silverskata/generative-engine/hardware/GenerativeEngineFaceplate.png

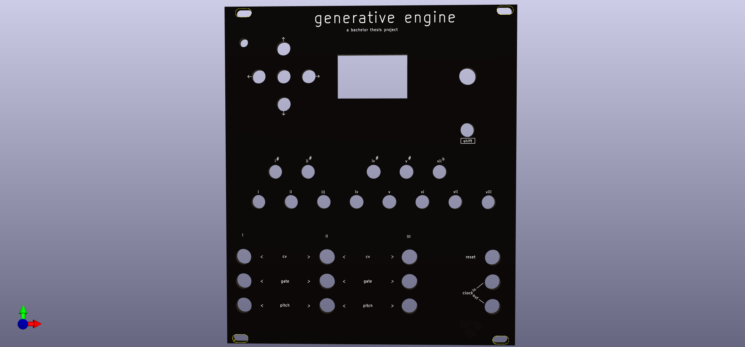
hardware/GenerativeEngineFaceplate.png
