silverskata/generative-engine/hardware/GenerativeEngine.kicad_pcb

## KiCad design hardware/GenerativeEngine.kicad_pcb (2022-05-01)

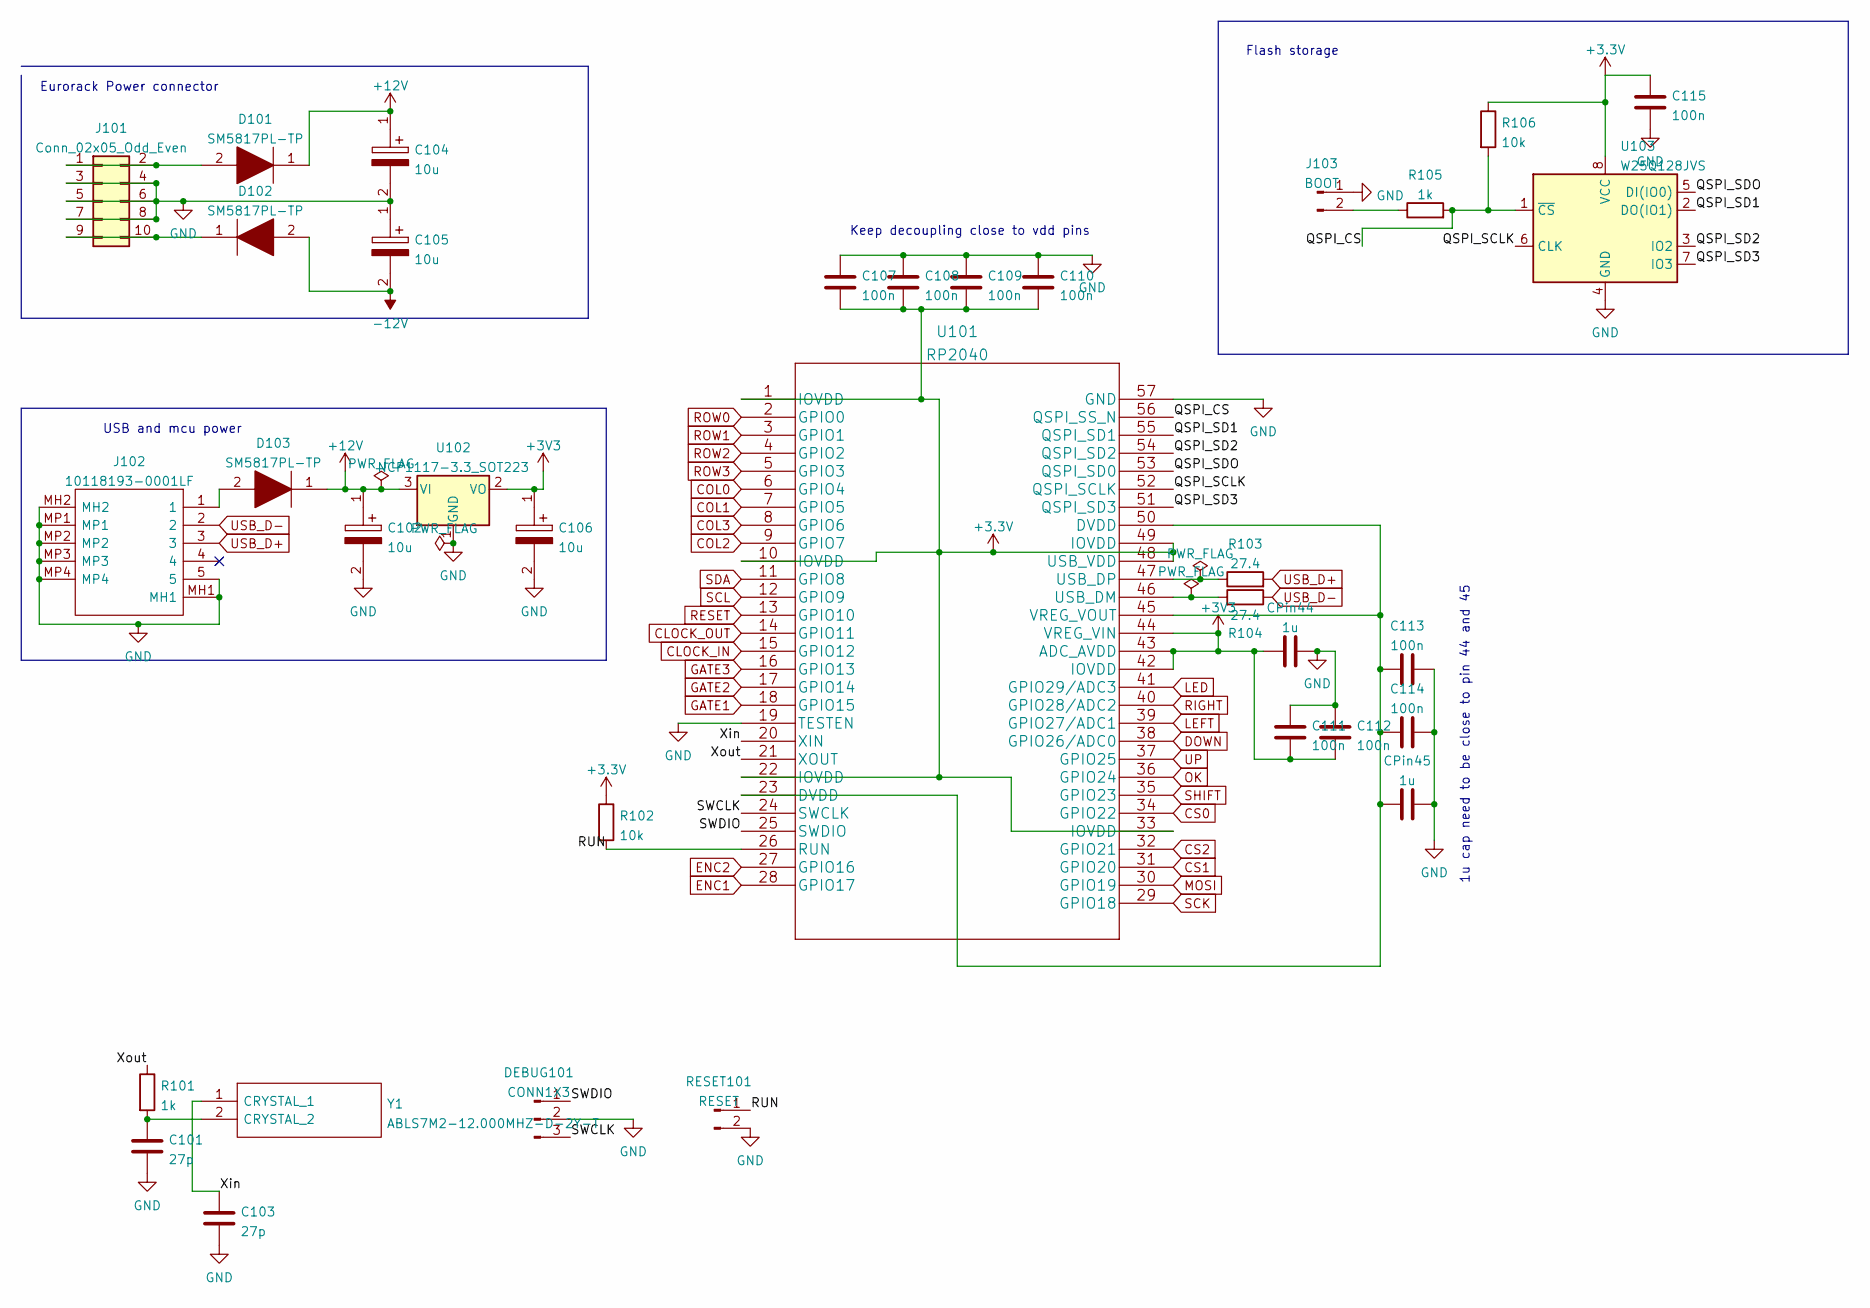
[picture p2: schematic GenMCU.kicad_sch]

Parts:
C101, C103: 27p; C_0603_1608Metric_Pad1.08x0.95mm_HandSolder
C102, C104, C105, C106: 10u; CAPAE530X550N; Mouser Part Number 710-865230340001
C107, C108, C109, C110, C111, C112, C113, C114, C115: 100n; C_0603_1608Metric_Pad1.08x0.95mm_HandSolder
CPin44, CPin45: 1u; C_0603_1608Metric_Pad1.08x0.95mm_HandSolder
D101, D102, D103: SM5817PL-TP; SOD3716X120N; Mouser Part Number 833-SM5817PL-TP
DEBUG101: CONN1X3; PinSocket_1x03_P2.54mm_Vertical
J101: Conn_02x05_Odd_Even; PinHeader_2x05_P2.54mm_Vertical
J102: 10118193-0001LF; 101181930001LF; Mouser Part Number 649-10118193-0001LF
J103: BOOT; PinHeader_1x02_P2.54mm_Vertical
R101, R105: 1k; R_0603_1608Metric_Pad0.98x0.95mm_HandSolder
R102, R106: 10k; R_0603_1608Metric_Pad0.98x0.95mm_HandSolder
R103, R104: 27.4; R_0603_1608Metric_Pad0.98x0.95mm_HandSolder
RESET101: RESET; PinHeader_1x02_P2.54mm_Vertical
U101: RP2040
U102: NCP1117-3.3_SOT223; SOT-223-3_TabPin2
U103: W25Q128JVS; SOIC-8_5.23x5.23mm_P1.27mm
Y1: ABLS7M2-12.000MHZ-D-2Y-T; ABLS7M212000MHZD2YT; Mouser Part Number 815-ABLS7M2-12-D-2YT

Connections:
+12V: C102.1, C104.1, D101.1, D103.1, U102.3 (VI); also elsewhere on the board
-12V: C105.2, D102.2; also elsewhere on the board
/GenMCU/QSPI_CS: R105.2, R106.2, U101.56 (QSPI_SS_N), U103.1 (~CS)
/GenMCU/QSPI_SCLK: U101.52 (QSPI_SCLK), U103.6 (CLK)
/GenMCU/QSPI_SD1: U101.55 (QSPI_SD1), U103.2 (DO(IO1))
/GenMCU/QSPI_SD2: U101.54 (QSPI_SD2), U103.3 (IO2)
/GenMCU/QSPI_SD3: U101.51 (QSPI_SD3), U103.7 (IO3)
/GenMCU/QSPI_SDO: U101.53 (QSPI_SD0), U103.5 (DI(IO0))
/GenMCU/RUN: R102.2, RESET101.1, U101.26 (RUN); also elsewhere on the board
/GenMCU/SWCLK: DEBUG101.3, U101.24 (SWCLK); also elsewhere on the board
/GenMCU/SWDIO: DEBUG101.1, U101.25 (SWDIO); also elsewhere on the board
/GenMCU/Xin: C103.1, U101.20 (XIN), Y1.1 (CRYSTAL)
/GenMCU/Xout: R101.1, U101.21 (XOUT)
CLOCK_IN: U101.15 (GPIO12); also elsewhere on the board
CLOCK_OUT: U101.14 (GPIO11); also elsewhere on the board
COL0: U101.6 (GPIO4); also elsewhere on the board
COL1: U101.7 (GPIO5); also elsewhere on the board
COL2: U101.9 (GPIO7); also elsewhere on the board
COL3: U101.8 (GPIO6); also elsewhere on the board
CS0: U101.34 (GPIO22); also elsewhere on the board
CS1: U101.31 (GPIO20); also elsewhere on the board
CS2: U101.32 (GPIO21); also elsewhere on the board
DOWN: U101.38 (GPIO26/ADC0); also elsewhere on the board
ENC1: U101.28 (GPIO17); also elsewhere on the board
ENC2: U101.27 (GPIO16); also elsewhere on the board
GATE1: U101.18 (GPIO15); also elsewhere on the board
GATE2: U101.17 (GPIO14); also elsewhere on the board
GATE3: U101.16 (GPIO13); also elsewhere on the board
GND: C101.2, C102.2, C103.2, C104.2, C105.1, C106.2, C107.1, C108.1, C109.1, C110.1, C111.1, C112.1, C113.2, C114.2, C115.2, CPin44.2, CPin45.2, DEBUG101.2, J101.3, J101.4, J101.5, J101.6, J101.7, J101.8, J102.5, J102.MH1, J102.MH2, J102.MP1, J102.MP2, J102.MP3, J102.MP4, J103.1, RESET101.2, U101.19 (TESTEN), U101.57 (GND), U102.1 (GND), U103.4 (GND); also elsewhere on the board
LED: U101.41 (GPIO29/ADC3); also elsewhere on the board
LEFT: U101.39 (GPIO27/ADC1); also elsewhere on the board
MOSI: U101.30 (GPIO19); also elsewhere on the board
unnamed: C101.1, R101.2, Y1.2 (CRYSTAL)
unnamed: C113.1, C114.1, CPin45.1, U101.23 (DVDD), U101.45 (VREG_VOUT), U101.50 (DVDD)
unnamed: D101.2, J101.1, J101.2
unnamed: D102.1, J101.9, J101.10
unnamed: D103.2, J102.1
unnamed 67: J103.2, R105.1; also elsewhere on the board
unnamed: R103.1, U101.47 (USB_DP)
unnamed: R104.2, U101.46 (USB_DM)
OK: U101.36 (GPIO24); also elsewhere on the board
RESET: U101.13 (GPIO10); also elsewhere on the board
RIGHT: U101.40 (GPIO28/ADC2); also elsewhere on the board
ROW0: U101.2 (GPIO0); also elsewhere on the board
ROW1: U101.3 (GPIO1); also elsewhere on the board
ROW2: U101.4 (GPIO2); also elsewhere on the board
ROW3: U101.5 (GPIO3); also elsewhere on the board
SCK: U101.29 (GPIO18); also elsewhere on the board
SCL: U101.12 (GPIO9); also elsewhere on the board
SDA: U101.11 (GPIO8); also elsewhere on the board
SHIFT: U101.35 (GPIO23); also elsewhere on the board
UP: U101.37 (GPIO25); also elsewhere on the board
USB_D+: J102.3, R103.2
USB_D-: J102.2, R104.1

Notes on the sheet:
USB and mcu power
1u cap need to be close to pin 44 and 45
Flash storage
Eurorack Power connector
Keep decoupling close to vdd pins

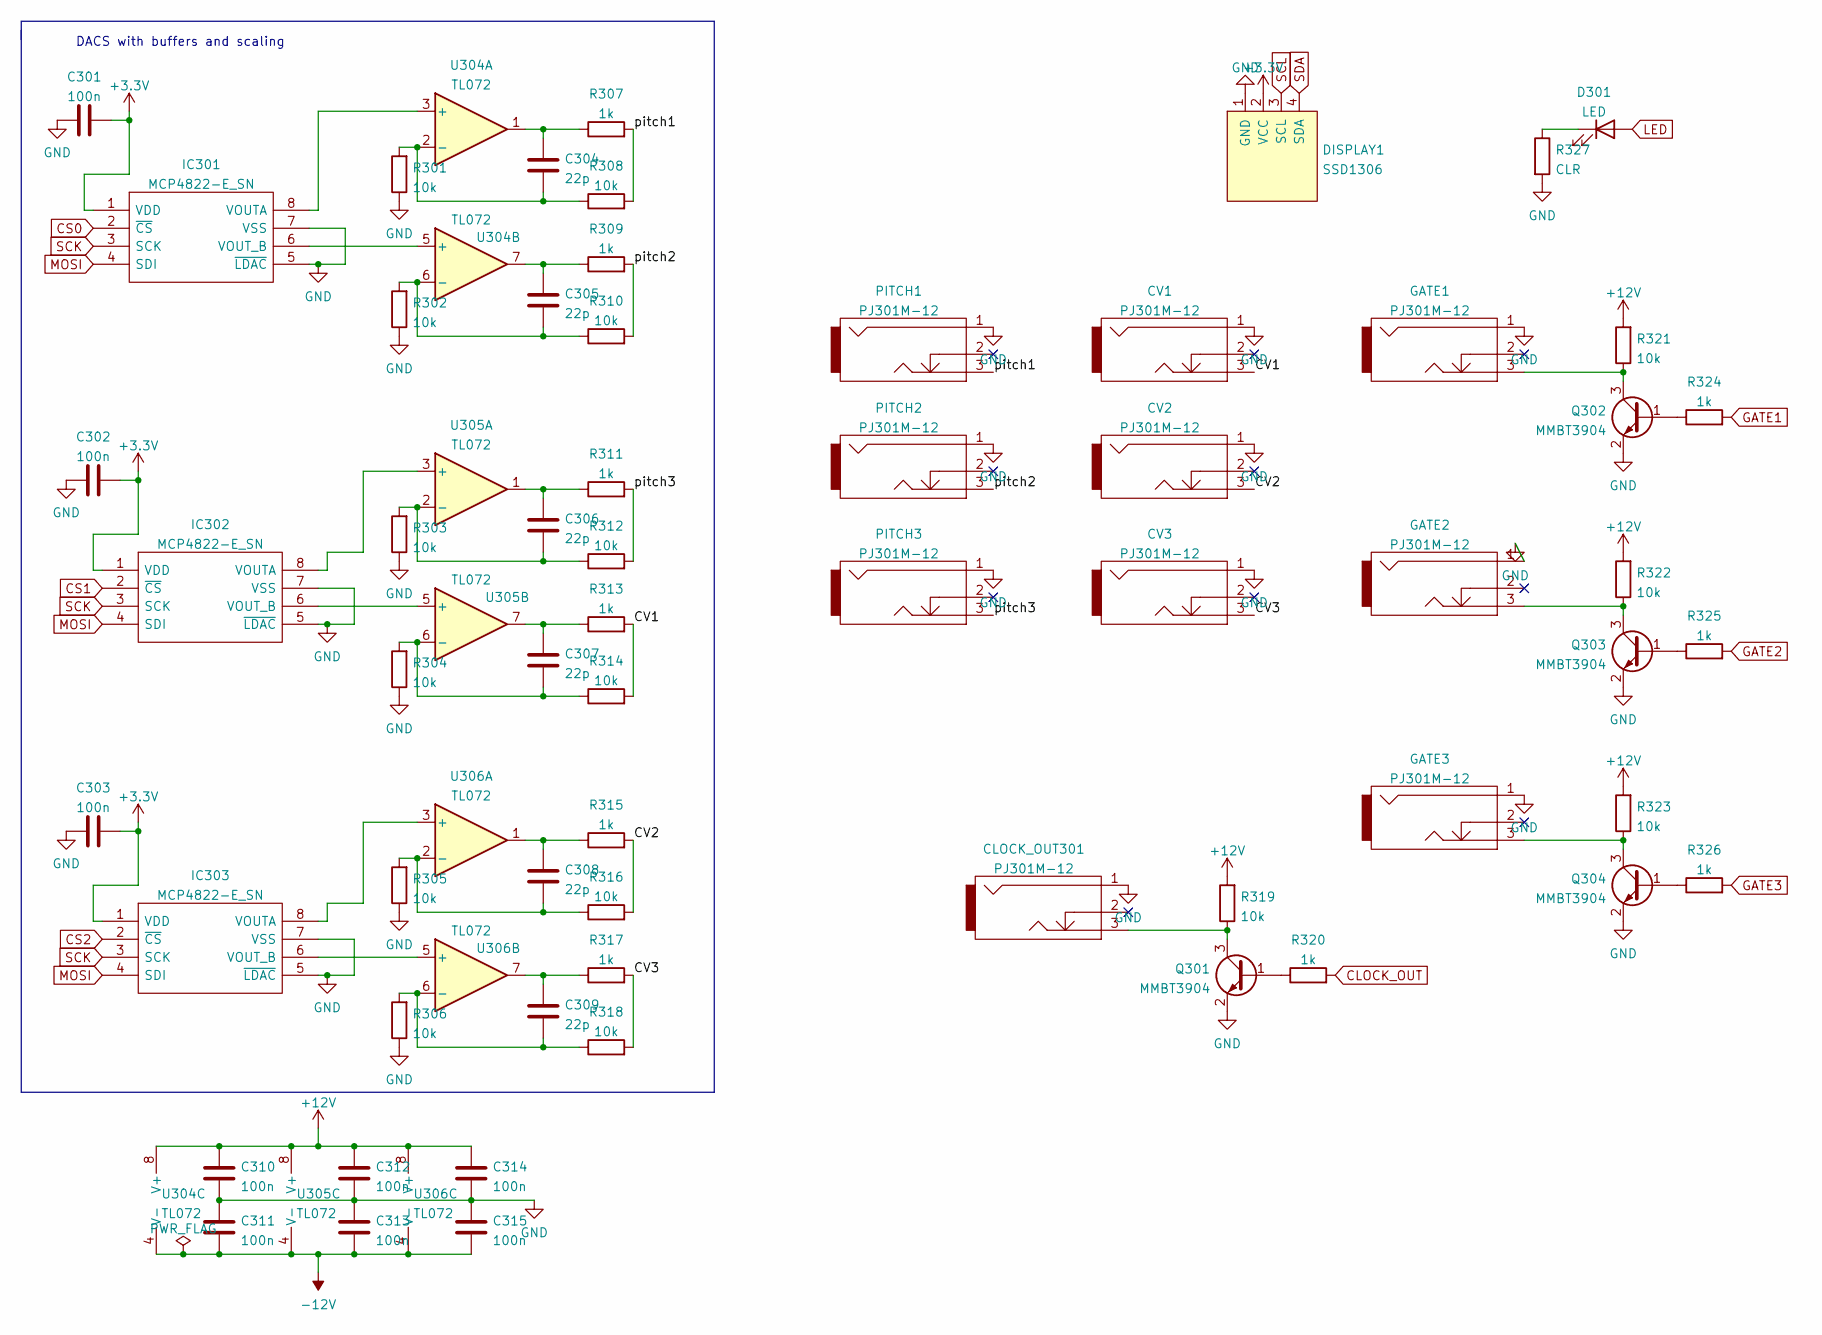
[picture p3: schematic GenOutput.kicad_sch]

Parts:
C301, C302, C303, C310, C311, C312, C313, C314, C315: 100n; C_0603_1608Metric_Pad1.08x0.95mm_HandSolder
C304, C305, C306, C307, C308, C309: 22p; C_0603_1608Metric_Pad1.08x0.95mm_HandSolder
CLOCK_OUT301: PJ301M-12
CV1, CV2, CV3: PJ301M-12
D301: LED; LED_D3.0mm
DISPLAY1: SSD1306; 128x64OLED
GATE1, GATE2, GATE3: PJ301M-12
IC301, IC302, IC303: MCP4822-E_SN; SOIC127P600X175-8N; Mouser Part Number 579-MCP4822-E/SN
PITCH1, PITCH2, PITCH3: PJ301M-12
Q301, Q302, Q303, Q304: MMBT3904; SOT-23
R301, R302, R303, R304, R305, R306, R308, R310, R312, R314, R316, R318, R319, R321, R322, R323: 10k; R_0603_1608Metric_Pad0.98x0.95mm_HandSolder
R307, R309, R311, R313, R315, R317, R320, R324, R325, R326: 1k; R_0603_1608Metric_Pad0.98x0.95mm_HandSolder
R327: CLR; R_0603_1608Metric_Pad0.98x0.95mm_HandSolder
U304, U305, U306: TL072; SOIC-8_3.9x4.9mm_P1.27mm

Connections:
+12V: C310.1, C312.1, C314.1, R319.2, R321.2, R322.2, R323.2, U304.8 (V+), U305.8 (V+), U306.8 (V+); also elsewhere on the board
-12V: C311.2, C313.2, C315.2, U304.4 (V-), U305.4 (V-), U306.4 (V-); also elsewhere on the board
/GenOutput/CV1: CV1.3, R313.2, R314.2
/GenOutput/CV2: CV2.3, R315.2, R316.2
/GenOutput/CV3: CV3.3, R317.2, R318.2
/GenOutput/pitch1: PITCH1.3, R307.2, R308.2
/GenOutput/pitch2: PITCH2.3, R309.2, R310.2
/GenOutput/pitch3: PITCH3.3, R311.2, R312.2
CLOCK_OUT: R320.2; also elsewhere on the board
CS0: IC301.2 (~CS); also elsewhere on the board
CS1: IC302.2 (~CS); also elsewhere on the board
CS2: IC303.2 (~CS); also elsewhere on the board
GATE1: R324.2; also elsewhere on the board
GATE2: R325.2; also elsewhere on the board
GATE3: R326.2; also elsewhere on the board
GND: C301.1, C302.1, C303.1, C310.2, C311.1, C312.2, C313.1, C314.2, C315.1, CLOCK_OUT301.1, CV1.1, CV2.1, CV3.1, DISPLAY1.1 (GND), GATE1.1, GATE2.1, GATE3.1, IC301.5 (~LDAC), IC301.7 (VSS), IC302.5 (~LDAC), IC302.7 (VSS), IC303.5 (~LDAC), IC303.7 (VSS), PITCH1.1, PITCH2.1, PITCH3.1, Q301.2 (E), Q302.2 (E), Q303.2 (E), Q304.2 (E), R301.1, R302.1, R303.1, R304.1, R305.1, R306.1, R327.2; also elsewhere on the board
LED: D301.2 (A); also elsewhere on the board
MOSI: IC301.4 (SDI), IC302.4 (SDI), IC303.4 (SDI); also elsewhere on the board
unnamed: C304.1, R307.1, U304.1
unnamed: C304.2, R301.2, R308.1, U304.2 (-)
unnamed: C305.1, R309.1, U304.7
unnamed: C305.2, R302.2, R310.1, U304.6 (-)
unnamed: C306.1, R311.1, U305.1
unnamed: C306.2, R303.2, R312.1, U305.2 (-)
unnamed: C307.1, R313.1, U305.7
unnamed: C307.2, R304.2, R314.1, U305.6 (-)
unnamed: C308.1, R315.1, U306.1
unnamed: C308.2, R305.2, R316.1, U306.2 (-)
unnamed: C309.1, R317.1, U306.7
unnamed: C309.2, R306.2, R318.1, U306.6 (-)
unnamed 53: CLOCK_OUT301.3, Q301.3 (C), R319.1; also elsewhere on the board
unnamed: D301.1 (K), R327.1
unnamed: GATE1.3, Q302.3 (C), R321.1
unnamed: GATE2.3, Q303.3 (C), R322.1
unnamed: GATE3.3, Q304.3 (C), R323.1
unnamed: IC301.6 (VOUT_B), U304.5 (+)
unnamed: IC301.8 (VOUTA), U304.3 (+)
unnamed: IC302.6 (VOUT_B), U305.5 (+)
unnamed: IC302.8 (VOUTA), U305.3 (+)
unnamed: IC303.6 (VOUT_B), U306.5 (+)
unnamed: IC303.8 (VOUTA), U306.3 (+)
unnamed: Q301.1 (B), R320.1
unnamed: Q302.1 (B), R324.1
unnamed: Q303.1 (B), R325.1
unnamed: Q304.1 (B), R326.1
SCK: IC301.3 (SCK), IC302.3 (SCK), IC303.3 (SCK); also elsewhere on the board

Notes on the sheet:
DACS with buffers and scaling

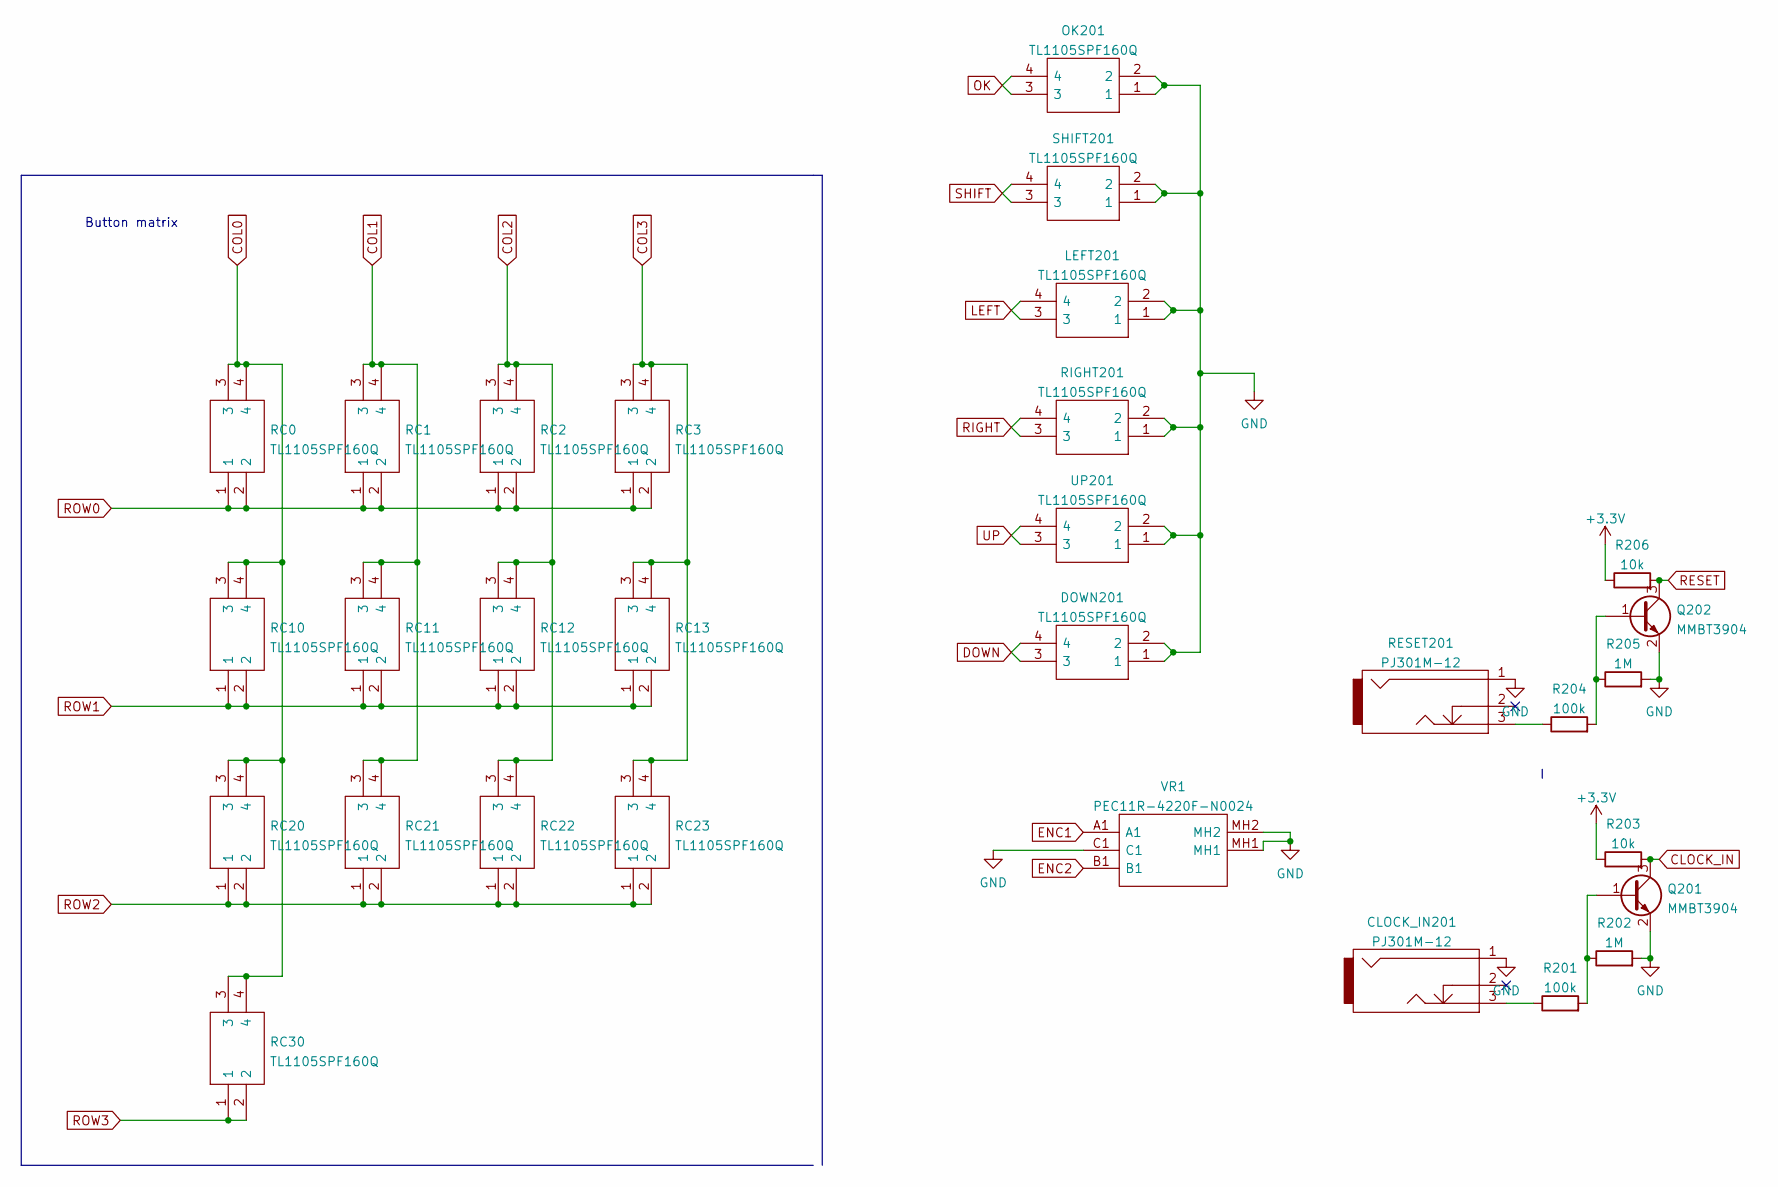
[picture p4: schematic GenInput.kicad_sch]

Parts:
CLOCK_IN201: PJ301M-12
DOWN201: TL1105SPF160Q; Mouser Part Number 612-TL1105SP
LEFT201: TL1105SPF160Q; Mouser Part Number 612-TL1105SP
OK201: TL1105SPF160Q; Mouser Part Number 612-TL1105SP
Q201, Q202: MMBT3904; SOT-23
R201, R204: 100k; R_0603_1608Metric_Pad0.98x0.95mm_HandSolder
R202, R205: 1M; R_0603_1608Metric_Pad0.98x0.95mm_HandSolder
R203, R206: 10k; R_0603_1608Metric_Pad0.98x0.95mm_HandSolder
RC0, RC1, RC2, RC3, RC10, RC11, RC12, RC13, RC20, RC21, RC22, RC23, RC30: TL1105SPF160Q; Mouser Part Number 612-TL1105SP
RESET201: PJ301M-12
RIGHT201: TL1105SPF160Q; Mouser Part Number 612-TL1105SP
SHIFT201: TL1105SPF160Q; Mouser Part Number 612-TL1105SP
UP201: TL1105SPF160Q; Mouser Part Number 612-TL1105SP
VR1: PEC11R-4220F-N0024; PEC11R4215FN0012; Mouser Part Number 652-PEC11R-4220F-N24

Connections:
CLOCK_IN: Q201.3 (C), R203.2; also elsewhere on the board
COL0: RC0.3, RC0.4, RC10.3, RC10.4, RC20.3, RC20.4, RC30.3, RC30.4; also elsewhere on the board
COL1: RC1.3, RC1.4, RC11.3, RC11.4, RC21.3, RC21.4; also elsewhere on the board
COL2: RC2.3, RC2.4, RC12.3, RC12.4, RC22.3, RC22.4; also elsewhere on the board
COL3: RC3.3, RC3.4, RC13.3, RC13.4, RC23.3, RC23.4; also elsewhere on the board
DOWN: DOWN201.3, DOWN201.4; also elsewhere on the board
GND: CLOCK_IN201.1, DOWN201.1, DOWN201.2, LEFT201.1, LEFT201.2, OK201.1, OK201.2, Q201.2 (E), Q202.2 (E), R202.2, R205.2, RESET201.1, RIGHT201.1, RIGHT201.2, SHIFT201.1, SHIFT201.2, UP201.1, UP201.2, VR1.C1, VR1.MH1, VR1.MH2; also elsewhere on the board
LEFT: LEFT201.3, LEFT201.4; also elsewhere on the board
unnamed 52: CLOCK_IN201.3, R201.1; also elsewhere on the board
unnamed: Q201.1 (B), R201.2, R202.1
unnamed: Q202.1 (B), R204.2, R205.1
unnamed: R204.1, RESET201.3
OK: OK201.3, OK201.4; also elsewhere on the board
RESET: Q202.3 (C), R206.2; also elsewhere on the board
RIGHT: RIGHT201.3, RIGHT201.4; also elsewhere on the board
ROW0: RC0.1, RC0.2, RC1.1, RC1.2, RC2.1, RC2.2, RC3.1, RC3.2; also elsewhere on the board
ROW1: RC10.1, RC10.2, RC11.1, RC11.2, RC12.1, RC12.2, RC13.1, RC13.2; also elsewhere on the board
ROW2: RC20.1, RC20.2, RC21.1, RC21.2, RC22.1, RC22.2, RC23.1, RC23.2; also elsewhere on the board
ROW3: RC30.1, RC30.2; also elsewhere on the board
SHIFT: SHIFT201.3, SHIFT201.4; also elsewhere on the board
UP: UP201.3, UP201.4; also elsewhere on the board

Notes on the sheet:
Button matrix

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
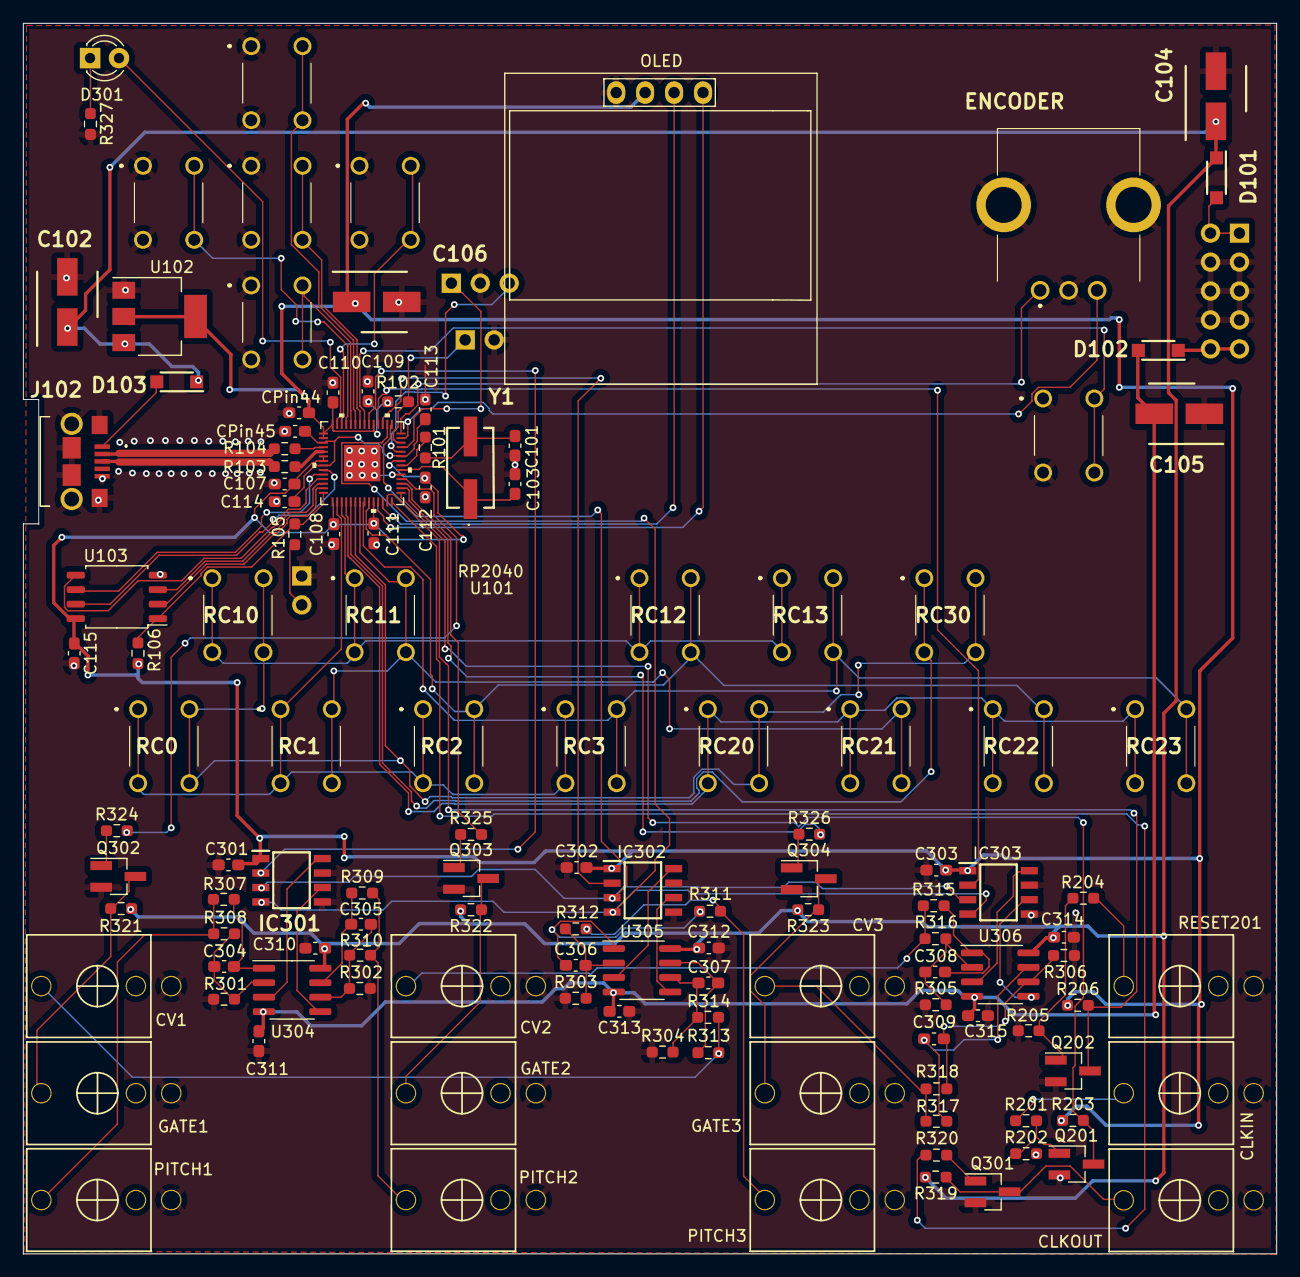
[picture p5: board GenerativeEngine.kicad_pcb from above]

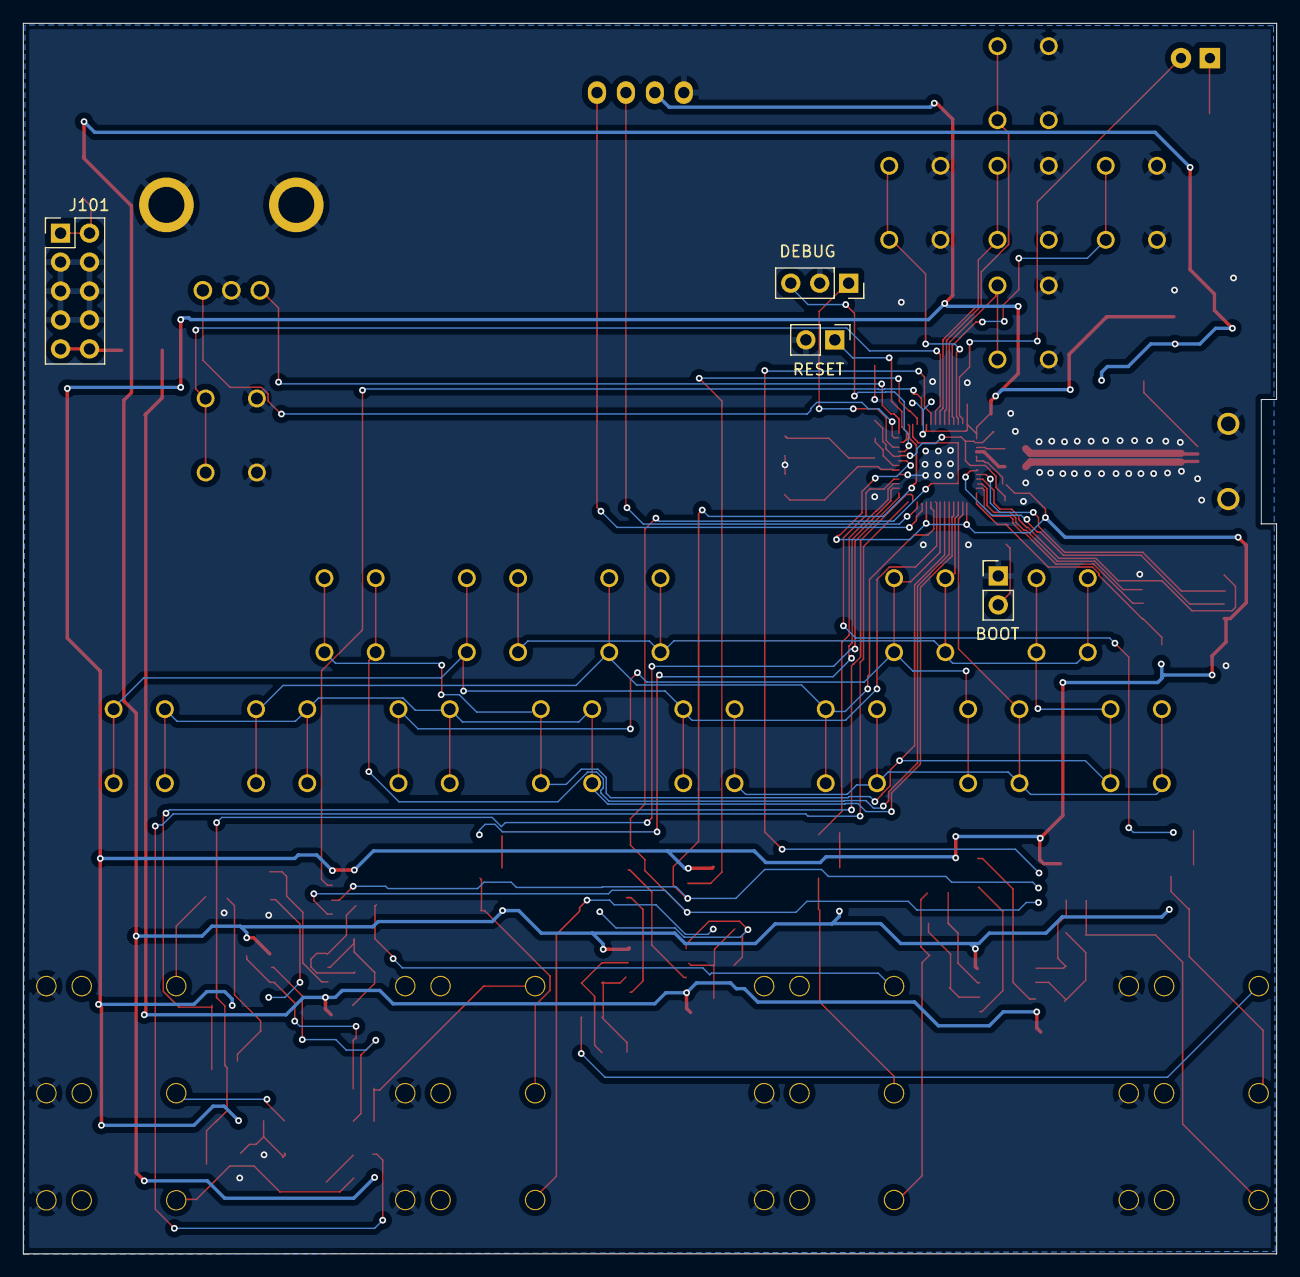
[picture p6: board GenerativeEngine.kicad_pcb from below]

Board: 2 copper layers, 110.0 x 108.0 mm, 129 parts (4 on the bottom side), 92 nets.

Other parts of the board:
BOOT: BOOT; PinHeader_1x02_P2.54mm_Vertical
CLKIN: PJ301M-12
CLKOUT: PJ301M-12
DEBUG: CONN1X3; PinSocket_1x03_P2.54mm_Vertical
ENCODER: PEC11R-4220F-N0024; PEC11R4215FN0012
OLED: SSD1306; 128x64OLED
RESET: RESET; PinHeader_1x02_P2.54mm_Vertical

Their connections:
/GenMCU/RUN: RESET.1; also elsewhere on the board
/GenMCU/SWCLK: DEBUG.3; also elsewhere on the board
/GenMCU/SWDIO: DEBUG.1; also elsewhere on the board
ENC1: ENCODER.A1; also elsewhere on the board
ENC2: ENCODER.B1; also elsewhere on the board
GND: BOOT.1, CLKIN.1, CLKOUT.1, DEBUG.2, ENCODER.C1, ENCODER.MH1, ENCODER.MH2, OLED.1 (GND), RESET.2; also elsewhere on the board
unnamed 52: CLKIN.3; also elsewhere on the board
unnamed 53: CLKOUT.3; also elsewhere on the board
unnamed 67: BOOT.2; also elsewhere on the board
SCL: OLED.3 (SCL); also elsewhere on the board
SDA: OLED.4 (SDA); also elsewhere on the board
