silverskata/generative-engine/software/src/controller.c

#include "../include/controller.h"



generator_t gen_s1;
generator_t gen_s2;
generator_t gen_harmony;
generator_t gen_scale;
generator_t gen_key;


uint16_t button_press = 0;
int16_t keyboard_press = -1;
int8_t encoder_direction = 0;


void control_task(controller_t *controller)
{
    if (!queue_is_empty(&controller->buttons->controlqueue))
    {
        button_press = read_control_queue(controller);
        if (!update_shift(controller, button_press));
    }
    else
        button_press = 0;
            if(controller->keyboard_active == 3 && !queue_is_empty(&controller->buttons->keyboardqueue)){
                keyboard_press = read_keyboard_queue(controller);
            }
            else keyboard_press = -1;
    if (multicore_fifo_rvalid())
        encoder_direction = multicore_fifo_pop_blocking();
    else
        encoder_direction = 0;

    if(controller->menu_active) menu_active_state(controller, button_press);
    else
        switch (controller->menu_state)
        {

        case MENU_CLOSED:
            update_state_main(controller, button_press, keyboard_press, encoder_direction);
            break;
        case EDIT_MENU:
            update_state_edit(controller, button_press, keyboard_press, encoder_direction);
            break;
        case GENERATE_MENU:
            update_state_generation(controller, button_press, encoder_direction);
            break;
        default:
            update_state_playing(controller, button_press, keyboard_press, encoder_direction);
            break;
        }
}

void menu_active_state(controller_t *self, uint16_t button_press)
{
    if(is_input(button_press))
    switch (button_press >> 1)
    {
    case BUTTON_LEFT:
    case (BUTTON_RIGHT):
        break;
    case (BUTTON_OK):
        if(!self->shift){
        switch(self->selection_state){
            case 0:
            self->menu_state = MAIN_PLAYING;
            break;
            case 1:
            self->menu_state = MENU_CLOSED;
            break;
            case 2:
            go_to_edit(self);
            break;
            case 3:
            self->menu_state = GENERATE_MENU;
            break;
            case 4:
            self->menu_state = SONG_MENU;
            break;
            case 5:
            self->menu_state = SAVE_MENU;
            break;
            case 6:
            self->menu_state = SETTINGS_MENU;
            break;
        }
        self->selection_state = 0;
        }
        self->menu_active = false;
        break;
    case (BUTTON_UP):
        self->selection_state --;
            if(self->selection_state<0) self->selection_state = 6;
    break;
    case (BUTTON_DOWN):
        self->selection_state ++;
            if(self->selection_state > 6) self->selection_state = 0;
    break;    
    }
}


void dynamic_generation(controller_t * control)
{       if(control->gen_harmony->active)
        gen_harmony_run(control->gen_harmony,&control->sequencer->sequencers[1]);
        if(control->gen_scale->active)
        gen_scale_run(control->gen_scale,control->sequencer);
        if(control->gen_key->active)
        gen_key_run(control->gen_key,control->sequencer);
        if(control->gen_s1->active)
        gen_sequence_run(control->gen_s1,&control->sequencer->sequencers[0]);
        if(control->gen_s2->active)
        gen_sequence_run(control->gen_s2,&control->sequencer->sequencers[1]);
}
char buffer[15];

char * gen_to_string(uint8_t generator,uint8_t select){
    generator_t *gen;
    switch(generator){ 
    case 0:        
        gen = &gen_s1;
    break;
    case 1:
        gen = &gen_s2;
    break;
    case 2:
        gen = &gen_key;
    break;
    case 3:
        gen = &gen_scale;
    break;
    case 4:
        gen = &gen_harmony;
    break;
    }
    switch(select){
        case 0:
            if(gen->active)
                sprintf(buffer,"ON");
            else  
                sprintf(buffer,"OFF");              
        break;
        case 1:
            sprintf(buffer,"%d",gen->base_prob);
        break;
        case 2:
            sprintf(buffer,"%d",gen->scale);
        break;
        case 3:
            sprintf(buffer,"%d",gen->range);
        break;
        case 4:
            sprintf(buffer,"%d",gen->delay);
        break;
        case 5:
            sprintf(buffer,"%d",gen->max_changes);
        break;
        case 6:
            if(gen->possible_val[0])
                sprintf(buffer,"ON");
            else  
                sprintf(buffer,"OFF"); 
        break;
        case 7:
            if(gen->possible_val[1])
                sprintf(buffer,"ON");
            else  
                sprintf(buffer,"OFF"); 
        break;
        case 8:
            if(gen->possible_val[2])
                sprintf(buffer,"ON");
            else  
                sprintf(buffer,"OFF"); 
        break;
        case 9:
            if(gen->possible_val[3])
                sprintf(buffer,"ON");
            else  
                sprintf(buffer,"OFF"); 
        break;
        case 10:
            if(gen->possible_val[4])
                sprintf(buffer,"ON");
            else  
                sprintf(buffer,"OFF"); 
        break;
        case 11:
            if(gen->possible_val[5])
                sprintf(buffer,"ON");
            else  
                sprintf(buffer,"OFF"); 
        break;
        case 12:
            if(gen->possible_val[6])
                sprintf(buffer,"ON");
            else  
                sprintf(buffer,"OFF");         
        break;
        case 13:
            if(gen->possible_val[7])
                sprintf(buffer,"ON");
            else  
                sprintf(buffer,"OFF");         
        break;
        case 14:
            if(gen->possible_val[8])
                sprintf(buffer,"ON");
            else  
                sprintf(buffer,"OFF");         
        break; 
        case 15:
            if(gen->possible_val[9])
                sprintf(buffer,"ON");
            else  
                sprintf(buffer,"OFF");         
        break; 
        case 16:
            if(gen->possible_val[10])
                sprintf(buffer,"ON");
            else  
                sprintf(buffer,"OFF");         
        break;        
        case 17:
            if(gen->possible_val[11])
                sprintf(buffer,"ON");
            else  
                sprintf(buffer,"OFF");         
        break;        
    }
    return buffer;
}

void generative_demo(controller_t * control){
    control->gen_s1->base_prob = 2;
    control->gen_s1->current_prob = 2;
    control->gen_s1->active = true;
    control->gen_s1->max_changes = 1;
    control->gen_s1->scale = 3;
    control->gen_s1->delay=1;
    control->gen_s1->possible_val[1] = 0;
    control->gen_s1->possible_val[3] = 0;
    control->gen_s1->possible_val[5] = 0;
    control->gen_harmony->active = true;
    control->gen_harmony->base_prob = 20;
    control->gen_harmony->current_prob = 20;
    control->gen_harmony->delay = 4;
    control->gen_harmony->max_changes = 2;
    control->gen_harmony-> scale = 5;
    control->gen_harmony->possible_val[0] = 0;
    control->gen_harmony->possible_val[1] = 0;
    control->gen_harmony->possible_val[3] = 0;


    control->gen_key->active=true;
    control->gen_key->base_prob = 90;
    control->gen_key->current_prob = 90;
    control->gen_key->delay =4;
    control->gen_key->scale = 5;
    control->gen_key->possible_val[7] = 0;
    control->gen_key->possible_val[2] = 0;
    control->gen_key->possible_val[3] = 0;
    control->gen_key->possible_val[4] = 0;
    control->gen_key->possible_val[1] = 0;
    control->gen_key->possible_val[5] = 1;
    control->gen_key->possible_val[6] = 1;
    control->gen_key->possible_val[0] = 0;
    control->gen_key->possible_val[8] = 0;
    control->gen_key->possible_val[9] = 0;
    control->gen_key->possible_val[10] = 0;
    control->gen_key->possible_val[11] = 0;
}


void init_controller(controller_t *control, button_control_t *buttons, sequencer_t *seq)
{
    control->sequencer = seq;
    control->buttons = buttons;
    control->shift = false;
    control->keyboard_active = 3;
    control->note.length = QUARTERNOTE;
    control->note.legato = QUARTERNOTE - 1;
    control->note.value = 0;
    control->note.octave = 1;
    control->note.modulation = 0;
    control->note.type = REGULAR_NOTE;
    control->dynamic_generation = false;
    control->menu_active = false;
    control->selection_sub_state = 0;
    control->gen_s1 = &gen_s1;
    control->gen_s2 = &gen_s2;
    control->gen_scale = &gen_scale;
    control->gen_key = &gen_key;
    control->gen_harmony = &gen_harmony;
    create_generator(&gen_s1);
    create_generator(&gen_s2);
    create_generator(&gen_harmony);
    create_generator(&gen_scale);
    create_generator(&gen_key);
    for(uint8_t i=0;i<6;i++)
        gen_scale.possible_val[7+i] = 0;
    gen_sequence_setup(&gen_s1,&seq->sequencers[0]);
    gen_sequence_setup(&gen_s2,&seq->sequencers[1]);

    //DEMO
    //generative_demo(control);
};

uint16_t read_control_queue(controller_t *self)
{
    uint16_t val;
    queue_remove_blocking(&self->buttons->controlqueue, &val);
    return val;
}

uint16_t read_keyboard_queue(controller_t *self)
{
    uint16_t val;
    queue_remove_blocking(&self->buttons->keyboardqueue, &val);
    return val;
}

bool is_input(uint16_t val)
{
    return (val & 0x01);
}

bool update_shift(controller_t *self, uint16_t button_press)
{
    if (button_press >> 1 != BUTTON_SHIFT)
        return false;
    if (is_input(button_press))
        self->shift = true;
    else
        self->shift = false;
    return true;
}
// 0 for off and 1 for on
void set_keyboard(controller_t *self, uint8_t onoff)
{
    if (onoff != 0)
        self->keyboard_active = 3;
    else
        self->keyboard_active = 1;
}
void select_note_length(controller_t *self, int8_t direction)
{
    self->note.length += direction;
    if (self->note.length > MAX_NOTE_LENGTH)
        self->note.length = MAX_NOTE_LENGTH;
    else if (self->note.length < 1)
        self->note.length = 1;
}

void update_state_playing(controller_t *self, uint16_t button_press, int16_t keyboard_press, int8_t encoder_direction)
{
    if (self->shift)
        set_tempo(self->sequencer, encoder_direction * 5);
    else
        set_tempo(self->sequencer, encoder_direction);

    if (is_input(button_press))
        switch (button_press >> 1)
        {
        case BUTTON_UP:
            self->sequencer->keyboard_octave++;
            if (self->sequencer->keyboard_octave>6)
            self->sequencer->keyboard_octave = 6;
        break;
        case BUTTON_DOWN:
            self->sequencer->keyboard_octave--;
            if (self->sequencer->keyboard_octave>7)
            self->sequencer->keyboard_octave = 0;
        break;
        case BUTTON_LEFT:
            if (!self->sequencer->playing)
                self->sequencer->current_step = 0;
            break;
        case (BUTTON_RIGHT):
            sequencer_pause_play(self->sequencer);
            break;
        case (BUTTON_OK):
        if(self->shift)
            self->dynamic_generation = !self->dynamic_generation;
        else
            self->menu_active = true;
            break;
        }
        if (keyboard_press > -1){
            if(is_input(keyboard_press))
                free_play_pressed(self->sequencer,unison_high_note_priority(self->buttons));
            else
                free_play_released(self->sequencer,unison_high_note_priority(self->buttons));
        }

}

uint8_t note_length_map[] = {THIRTYSECONDNOTE, SIXTEENTHNOTE, DOTTEDSIXTEENTH, EIGHTNOTE, DOTTEDEIGHT, QUARTERNOTE, DOTTEDQUARTER, SEMINOTE, DOTTEDSEMI, WHOLENOTE};
uint8_t staccato = 1;
void update_state_edit(controller_t *self, uint16_t button_press, int16_t keyboard_press, int8_t encoder_direction)
{
    if(is_input(keyboard_press))
        keyboard_press = keyboard_press >> 1;
    else keyboard_press = -1;

    int8_t selection_direction = 0;
    if (is_input(button_press))
    {
        switch (button_press >> 1)
        {
        case BUTTON_LEFT:
        if(self->shift && self->sequencer->active_sequence !=0)
            self->sequencer->active_sequence--;
        else if (self->sequencer->sequencers[self->sequencer->active_sequence].selected_step > 0)
                step_reverse(self->sequencer);
            break;
        case (BUTTON_RIGHT):
            if (self->shift && self->sequencer->active_sequence != SEQUENCER_AMOUNT -1)
                self->sequencer->active_sequence++;
            else
            {
                step_forward(self->sequencer);
            }
            break;
        case (BUTTON_UP):
            // SHIFT UP raises the selected note value;
            if (self->sequencer->sequencers[self->sequencer->active_sequence].note_value[self->sequencer->sequencers
                [self->sequencer->active_sequence].current_page][self->sequencer->sequencers[self->sequencer->active_sequence].selected_step]
                        .type != NO_NOTE &&
                self->sequencer->sequencers[self->sequencer->active_sequence].note_value[self->sequencer->sequencers
                [self->sequencer->active_sequence].current_page][self->sequencer->sequencers[self->sequencer->active_sequence].selected_step]
                        .type != REST_NOTE &&
                self->shift)
                edit_step_value(self->sequencer, 1);
            else if (self->sequencer->sequencers[self->sequencer->active_sequence].note_value[self->sequencer->sequencers
                    [self->sequencer->active_sequence].current_page][self->sequencer->sequencers[self->sequencer->active_sequence].selected_step]
                         .type != REST_NOTE)
            {
                self->note.octave++;
                if (self->note.octave > 5)
                    self->note.octave = 5;
            }
            break;
        case (BUTTON_DOWN):
            // SHIFT DOWN lowers the selected note value;
            if (self->sequencer->sequencers[self->sequencer->active_sequence].note_value[self->sequencer->sequencers
                [self->sequencer->active_sequence].current_page][self->sequencer->sequencers[self->sequencer->active_sequence].selected_step]
                        .type != NO_NOTE &&
                self->sequencer->sequencers[self->sequencer->active_sequence].note_value[self->sequencer->sequencers
                [self->sequencer->active_sequence].current_page][self->sequencer->sequencers[self->sequencer->active_sequence].selected_step]
                        .type != REST_NOTE &&
                self->shift)
                edit_step_value(self->sequencer, -1);
            else if (self->sequencer->sequencers[self->sequencer->active_sequence].note_value[self->sequencer->sequencers
                    [self->sequencer->active_sequence].current_page][self->sequencer->sequencers[self->sequencer->active_sequence].selected_step]
                         .type != REST_NOTE)
            {
                self->note.octave--;
                if (self->note.octave > 5)
                    self->note.octave = 0;
            }
            break;
        case (BUTTON_OK):
            if (!self->shift)
                self->menu_active = true;
            else
               self->sequencer->sequencers[self->sequencer->active_sequence].note_value[self->sequencer->sequencers
                [self->sequencer->active_sequence].current_page][self->sequencer->sequencers[self->sequencer->active_sequence].selected_step].protected = 
                !self->sequencer->sequencers[self->sequencer->active_sequence].note_value[self->sequencer->sequencers
                [self->sequencer->active_sequence].current_page][self->sequencer->sequencers[self->sequencer->active_sequence].selected_step].protected;

            break;
        }
    }

    if (keyboard_press > -1)
    {
        switch (keyboard_press)
        {
        case 1: /*** TODO  ADD FUNCTIONS TO THE BLACK KEYS**/
            selection_direction--;
            break;
        case 3:
            selection_direction++;
            break;
        case 6:
            self->note.legato--;
            if (self->note.legato < 1)
                self->note.legato = 1;
            break;
        case 8:
            self->note.legato++;
            if (self->note.legato > self->note.length)
                self->note.legato = self->note.length;
            break;
        case 10:
            set_rest_step(self->sequencer, self->note.length);
            step_forward(self->sequencer);
            break;
        case 12:
            self->note.octave++;
            keyboard_press = 0;
            if (self->sequencer->sequencers[self->sequencer->active_sequence].note_value[self->sequencer->sequencers
                [self->sequencer->active_sequence].current_page][self->sequencer->sequencers[self->sequencer->active_sequence].selected_step]
                    .type != NEXT_NOTE)
            {
                keyboard_step_value(&self->note, keyboard_press);
                set_note(self->sequencer, &self->sequencer->sequencers[self->sequencer->active_sequence], self->sequencer->sequencers[self->sequencer->active_sequence].selected_step, self->note);
            }
            else
            {
                keyboard_step_value(&self->note, keyboard_press);
                add_note(self->sequencer, self->note);
            }
            self->note.octave--;
            break;
        default:
            if (self->sequencer->sequencers[self->sequencer->active_sequence].note_value[self->sequencer->sequencers
                [self->sequencer->active_sequence].current_page][self->sequencer->sequencers[self->sequencer->active_sequence].selected_step]
                    .type != NEXT_NOTE)
            {
                keyboard_step_value(&self->note, keyboard_press);
                set_note(self->sequencer, &self->sequencer->sequencers[self->sequencer->active_sequence], self->sequencer->sequencers[self->sequencer->active_sequence].selected_step, self->note);
            }
            else
            {
                keyboard_step_value(&self->note, keyboard_press);
                add_note(self->sequencer, self->note);
            }
        }
    }

    if (selection_direction != 0)
    {
        self->selection_state += selection_direction;
        if (self->selection_state > 9)
            self->selection_state = 0;
        else if (self->selection_state < 0)
            self->selection_state = 9;
        self->note.length = note_length_map[self->selection_state];
        self->note.legato = self->note.length - staccato;
    }
}

void update_state_main(controller_t *self, uint16_t button_press, int16_t keyboard_press, int8_t encoder_direction)
{
    int8_t selection_direction = 0;
    if (is_input(button_press))
    {
        switch (button_press >> 1)
        {
        case BUTTON_LEFT:
            self->selection_state--;
            if (self->selection_state < 0)
                self->selection_state = 6;
            break;
        case (BUTTON_RIGHT):
            if (self->shift)
                sequencer_pause_play(self->sequencer);
            else
            {
                self->selection_state++;
                if (self->selection_state > 6)
                    self->selection_state = 0;
            }
            break;
        case (BUTTON_UP):
            selection_direction = 1;
            break;
        case (BUTTON_DOWN):
            selection_direction = -1;
            break;
        case (BUTTON_OK):
            if (self->shift){
                self->menu_active = false;
            }
            else
                switch (self->selection_state)
                {
                case 0: // Open the main menu
                    self->selection_state = 0;
                    self->menu_active = true;
                    break;
                case 3: // notes selected
                    go_to_edit(self);
                    break;
                case 5:
                    sequence_on_off(self->sequencer);
                    break;
                default:
                    break;
                }
            break;
        }
    }
    if (encoder_direction != 0)
        selection_direction = encoder_direction;
    if (selection_direction != 0)
        switch (self->selection_state)
        {
        case 0: // MENU
            self->selection_state = 1;
            self->menu_active = true;
            break;
        case 1: // KEY
            select_key(self->sequencer, selection_direction);
            break;
        case 2: // SCALE
            select_scale(self->sequencer, selection_direction);
            break;
        case 3: // NOTES nop
            break;
        case 4: // PAGE
            select_page(self->sequencer, selection_direction);
            break;
        case 5: // SEQUENCER
            select_active_sequencer(self->sequencer, selection_direction);
            break;
        case 6: // TEMPO
            if (self->shift)
                set_tempo(self->sequencer, selection_direction * 5);
            else
                set_tempo(self->sequencer, selection_direction);
            break;
        }
}




void update_state_generation(controller_t *self, uint16_t button_press, int8_t encoder_direction)
{
    int8_t selection_direction = 0;
    if (is_input(button_press))
        switch (button_press >> 1)
        {
        case BUTTON_LEFT:
            // SHIFT LEFT BUTTON ACTS AS A BACK BUTTON, WILL BE ADDED IN NEXT ITERATION OF THE HARDWARE
            if (self->selection_sub_state == 0){
                    self->selection_state --;
                    if(self->selection_state<0)
                    self->selection_state = GENERATOR_AMOUNT-1;
            }
            else
                selection_direction =-1;
        break;
            case (BUTTON_RIGHT):
                if (self->selection_sub_state == 0){
                    self->selection_state ++;
                    if(self->selection_state>=GENERATOR_AMOUNT)
                        self->selection_state = 0;
                }
                else 
                selection_direction =1;
            break;
        case (BUTTON_OK):
        self->menu_active = true;
            break;
        case BUTTON_UP:
            self->selection_sub_state --;
             switch(self->selection_state){
                case 2: //Key
                    if(self->selection_sub_state<0) self->selection_sub_state = 17;
                break;
                case 3: // Scale
                    if(self->selection_sub_state<0) self->selection_sub_state = 12;
                break;
                default: //sequencers and harmony
                    if(self->selection_sub_state<0) self->selection_sub_state = 13;
                break;                                               
            }
        break;
        case BUTTON_DOWN:
            self->selection_sub_state ++;
            switch(self->selection_state){
                case 2: //Key
                    if(self->selection_sub_state>17) self->selection_sub_state = 0;
                break;
                case 3: // Scale
                    if(self->selection_sub_state>12) self->selection_sub_state = 0;
                break;
                default: //sequencers and harmony
                    if(self->selection_sub_state>13) self->selection_sub_state = 0;
                break;                                               
            }
        break;
        }

        if(encoder_direction !=0) selection_direction = encoder_direction;
        if(selection_direction !=0)
        switch (self->selection_state)
        {
        case 0: // Sequence 1
            gen_sequence_set(self->gen_s1,self->selection_sub_state,selection_direction);
        break;
        case 1: // Sequence 2
            gen_sequence_set(self->gen_s2,self->selection_sub_state,selection_direction);
        break;
        case 2: // Key
            if(self->selection_sub_state >5)
                gen_key_set(self->gen_key, self->selection_sub_state + 1, selection_direction);
            else
                gen_key_set(self->gen_key, self->selection_sub_state, selection_direction);
        break;
        case 3: // scale
            if(self->selection_sub_state >5)
                gen_scale_set(self->gen_scale, self->selection_sub_state + 1, selection_direction);
            else
                gen_scale_set(self->gen_scale, self->selection_sub_state, selection_direction);
        break;
        case 4: // harmony
            gen_harmony_set(self->gen_harmony, self->selection_sub_state, selection_direction);
        break;
        }
}
/*** TODO ***/
void update_state_song(controller_t *self, uint16_t button_press)
{
    if(is_input(button_press))
    switch (button_press >> 1)
    {
    case BUTTON_LEFT:
        // SHIFT LEFT BUTTON ACTS AS A BACK BUTTON, WILL BE ADDED IN NEXT ITERATION OF THE HARDWARE
        if (self->shift && self->selection_state == 0){
            self->menu_state = MAIN_PLAYING;
            self->old_state = self->menu_state;
        }
        else if (self->shift && self->selection_state != 0)
            self->selection_state = 0;
        break;
    case (BUTTON_RIGHT):
        break;
    case (BUTTON_OK):
            //TODO PLACEHOLDER BACK STATEMENT
        self->menu_state = MAIN_PLAYING;
        break;
    }
}
/*** TODO ***/
void update_state_sequencers(controller_t *self, uint16_t button_press)
{
    switch (button_press >> 1)
    {
    case BUTTON_LEFT:
        // SHIFT LEFT BUTTON ACTS AS A BACK BUTTON, WILL BE ADDED IN NEXT ITERATION OF THE HARDWARE
        if (self->shift && self->selection_state == 0){
            self->old_state = self->menu_state;
            self->menu_state = MAIN_PLAYING;
        }
        else if (self->shift && self->selection_state != 0)
            self->selection_state = 0;
        break;
    case (BUTTON_RIGHT):
        break;
    case (BUTTON_OK):
            //TODO PLACEHOLDER BACK STATEMENT
        self->menu_state = MAIN_PLAYING;
        break;
    }
}
/*** TODO ***/
void update_state_settings(controller_t *self, uint16_t button_press)
{
    switch (button_press >> 1)
    {
    case BUTTON_LEFT:
        // SHIFT LEFT BUTTON ACTS AS A BACK BUTTON, WILL BE ADDED IN NEXT ITERATION OF THE HARDWARE
        if (self->shift && self->selection_state == 0)
            self->menu_state = MAIN_PLAYING;
        else if (self->shift && self->selection_state != 0)
            self->selection_state = 0;
        break;
    case (BUTTON_RIGHT):
        break;
    case (BUTTON_OK):
            //TODO PLACEHOLDER BACK STATEMENT
        self->menu_state = MAIN_PLAYING;
        break;
    }
}

/*** TODO ***/
void update_state_save(controller_t *self, uint16_t button_press)
{
    if(is_input(button_press))
    switch (button_press >> 1)
    {
    case BUTTON_LEFT:
        // SHIFT LEFT BUTTON ACTS AS A BACK BUTTON, WILL BE ADDED IN NEXT ITERATION OF THE HARDWARE
        if (self->shift && self->selection_state == 0)
            self->menu_state = MAIN_PLAYING;
        else if (self->shift && self->selection_state != 0)
            self->selection_state = 0;
        break;
    case (BUTTON_RIGHT):

        break;
    case (BUTTON_OK):
            //TODO PLACEHOLDER BACK STATEMENT
        self->menu_state = MAIN_PLAYING;
        break;
    }
}

void go_to_edit(controller_t *self)
{
    self->menu_state = EDIT_MENU; // EDIT NOTES MENU
    self->selection_state = 5;
    self->keyboard_active = 3;
    reset_notes();
}
