silverskata/generative-engine/software/include/button_definition.h

// BUTTONS
#define RIGHT 28
#define LEFT 27
#define UP 25
#define OK 24
#define DOWN 26
#define ROW0 0
#define ROW1 1
#define ROW2 2
#define ROW3 3
#define COL0 4
#define COL1 5
#define COL2 6
#define COL3 7
#define SHIFT 23
#define BUTTON_C 17
#define BUTTON_C_SHARP 33
#define BUTTON_D 18
#define BUTTON_D_SHARP 34
#define BUTTON_E 24
#define BUTTON_F 20
#define BUTTON_F_SHARP 40
#define BUTTON_G 65
#define BUTTON_G_SHARP 36
#define BUTTON_A 66
#define BUTTON_B_FLAT 129
#define BUTTON_B 72
#define BUTTON_REST 68
#define BUTTON_LEFT 0x01
#define BUTTON_RIGHT 0x02
#define BUTTON_UP 0x04
#define BUTTON_DOWN 0x08
#define BUTTON_OK 0x10
#define BUTTON_SHIFT 0x20
#define KEYBOARD_ONE 0x0001
#define KEYBOARD_TWO 0x0002
#define KEYBOARD_THREE 0x0004
#define KEYBOARD_FOUR 0x0008
#define KEYBOARD_FIVE 0x0010
#define KEYBOARD_SIX 0x0020
#define KEYBOARD_SEVEN 0x0040
#define KEYBOARD_EIGHT 0x0080
#define KEYBOARD_NINE 0x0100
#define KEYBOARD_TEN 0x0200
#define KEYBOARD_ELEVEN 0x0400
#define KEYBOARD_TVELVE 0x0800
#define KEYBOARD_THIRTEEN 0x1000
