silverskata/generative-engine/(commit log)

2022-05-01 Hardware version 1.0
    [GenInput.kicad_sch, GenMCU.kicad_sch, GenOutput.kicad_sch, GenPeriferial.kicad_sch, GenPower.kicad_sch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]
2022-05-01 First software commit
    [GenerativeEngine-B_Cu.gbl, GenerativeEngine-B_Mask.gbs, GenerativeEngine-B_Paste.gbp, GenerativeEngine-B_Silkscreen.gbo, GenerativeEngine-Edge_Cuts.gm1, GenerativeEngine-F_Cu.gtl, GenerativeEngine-F_Mask.gts, GenerativeEngine-F_Paste.gtp]
2022-05-28 Generation UI and logic fixed
    [controller.c, controller.h, generate.c, generate.h, main.c, sequencer.c, sequencer.h, ui.c]
2022-05-31 Scale generation (finally) fixed
    [controller.c, generate.c, main.c, sequencer.c, ui.c, ui.h]
